PajareraSOA/FireBirdProject/README.md

# FireBird



## Integrantes

 * Menendez Leonel Ezequiel ([LeonelMenendez](https://github.com/LeonelMenendez))
* Raimondo Pablo Andrés ([PabloRai](https://github.com/PabloRai))
* Ruttimann Hernan Pablo ([rutimannh](https://github.com/PabloRai))
* Saccella Claudio Damian ([cdsaccella](https://github.com/cdsaccella))
* Scarpione Lautaro Nicolas  ([LautaroScarpione](https://github.com/LautaroScarpione))
* Vespoli Nicolas  ([NicoVespoli](https://github.com/NicoVespoli))

### About
 * FireBird es el resultado de nuestro proyecto para la materia Sistemas Operativos Avanzados, posee un SE( Arduino Uno) +IoT ya que se agregó un módulo Bluetooth para su conexión con otros dispositivos, en este caso, un dispositivo con Android el cual recibirá información actual sobre la comida del ave y los niveles de humo, flama y temperatura de la cercania de la pajarera.
