PajareraSOA/FireBirdProject/(commit log)

2017-11-28 Se pule el codigo del Arduino y del Android
2017-11-28 Se elimina la clase no usada y pequeño refactor
